Y2K-x/WiFiflex-JLC/KiCad/WifiFlex-connector.kicad_sch

## KiCad design KiCad/WifiFlex-connector.kicad_sch (2024-02-01)

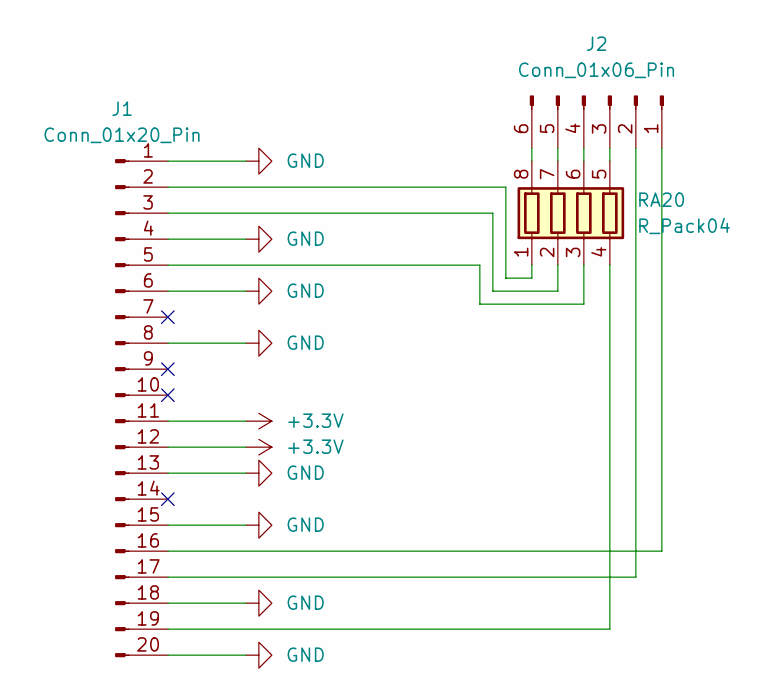
[picture p1: schematic WifiFlex-connector.kicad_sch]

Parts:
J1: Conn_01x20_Pin; Molex_SlimStack_52991-0208_2x10_P0.50mm_Vertical
J2: Conn_01x06_Pin; wififlex
RA20: R_Pack04; R_Array_Convex_4x0402

Connections:
+3.3V: J1.11, J1.12
GND: J1.1, J1.4, J1.6, J1.8, J1.13, J1.15, J1.18, J1.20
unnamed: J1.2, RA20.1 (R1.1)
unnamed: J1.3, RA20.2 (R2.1)
unnamed: J1.5, RA20.3 (R3.1)
unnamed: J1.16, J2.1
unnamed: J1.17, J2.2
unnamed: J1.19, RA20.4 (R4.1)
unnamed: J2.3, RA20.5 (R4.2)
unnamed: J2.4, RA20.6 (R3.2)
unnamed: J2.5, RA20.7 (R2.2)
unnamed: J2.6, RA20.8 (R1.2)
